tpII/2026-j2-pressure-sensitive-stylus/docs/img/Captura de pantalla 2026-10-01 205044.png

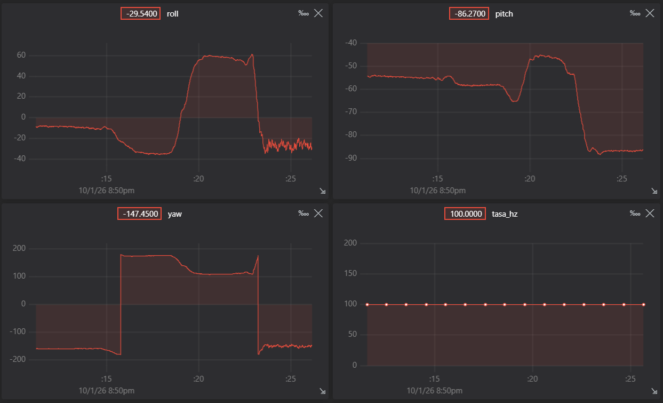
docs/img/Captura de pantalla 2026-10-01 205044.png
