tpII/2026-j2-pressure-sensitive-stylus/docs/img/Captura de pantalla 2026-10-10 220511.png

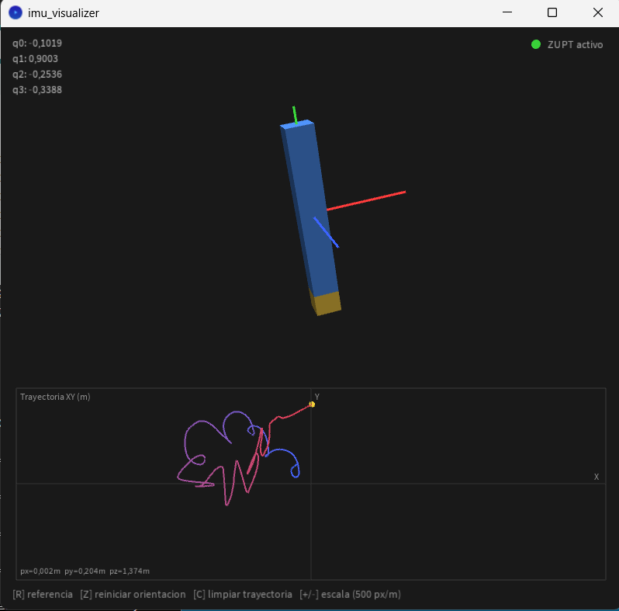
docs/img/Captura de pantalla 2026-10-10 220511.png
