tpII/2026-j2-pressure-sensitive-stylus/firmware/ensayos/resultados/2026-10-01_t3_resumen.md

# Test 3 - Calibracion estatica y deriva del giroscopo (2026-10-01)

Hardware: ESP32 DevKit (ESP-WROOM-32) + GY-521 MPU6050 original (WHO_AM_I = 0x68), en protoboard, alimentado por USB.
Configuracion: acelerometro +-4 g, giroscopo +-500 dps, DLPF 44 Hz, muestreo 100 Hz.
Archivos: `2026-10-01_t3_calibracion_salida.txt` (salida completa), `2026-10-01_t3_deriva.csv` (tabla de deriva).

## Offsets y ruido (1000 muestras, sensor quieto)

| Eje | Media | Desvio (ruido) |
|---|---|---|
| ax | +1.0280 g | 0.0017 g |
| ay | -0.0198 g | 0.0024 g |
| az | -0.0855 g | 0.0026 g |
| gx | -0.4318 deg/s | 0.0459 deg/s |
| gy | -0.1643 deg/s | 0.0951 deg/s |
| gz | +0.5116 deg/s | 0.0488 deg/s |

- |g| medido = 1.0317 g (error de escala/offset del acelerometro ~3 %).
- La gravedad cayo sobre el eje X (ax ~ 1 g): el sensor estaba apoyado de costado, no con el chip hacia arriba. No afecta el bias del giroscopo ni la deriva; para el offset del acelerometro conviene repetir con el sensor plano.
- Ruido del giroscopo: 0.05-0.10 deg/s; ruido del acelerometro: ~2-3 mg.

## Deriva por integracion del giroscopo (60 s)

| | X | Y | Z |
|---|---|---|---|
| Sin correccion de bias | -25.4 deg | -9.5 deg | +30.4 deg |
| Con correccion de bias | +0.55 deg | +0.34 deg | -0.27 deg |

- Sin correccion, la deriva es lineal y coincide con bias x tiempo (ej. -0.4318 deg/s x 60 s = -25.9 deg): el error dominante es el bias constante.
- Restando el bias medido, la deriva baja a < 0.6 deg/min (reduccion ~50x). El residuo crece lentamente: deriva del bias (temperatura) y ruido integrado (random walk).
- Conclusion: la integracion pura del giroscopo no alcanza ni con calibracion para uso prolongado; justifica fusionar con el acelerometro (filtro de Madgwick) para roll/pitch. El yaw no tiene referencia absoluta y conserva esta deriva residual.
