tpII/2026-j2-pressure-sensitive-stylus/docs/resultados/ensayos_iniciales_t1-t4/2026-10-01_204615_t4_madgwick.csv

t_s | variable | valor
0.0035 | roll | 103.09
0.0045 | pitch | -83.91
0.0045 | yaw | 41.27
0.0130 | roll | 102.4
0.0130 | pitch | -83.84
0.0140 | yaw | 41.96
0.0227 | roll | 101.64
0.0237 | pitch | -83.81
0.0237 | yaw | 42.72
0.0329 | roll | 100.98
0.0339 | pitch | -83.74
0.0339 | yaw | 43.38
0.0429 | roll | 100.75
0.0429 | pitch | -83.84
0.0439 | yaw | 43.6
0.0519 | roll | 101.51
0.0529 | pitch | -83.88
0.0529 | yaw | 42.85
0.0620 | roll | 102.2
0.0630 | pitch | -83.94
0.0630 | yaw | 42.16
0.0725 | roll | 101.5
0.0725 | pitch | -83.98
0.0735 | yaw | 42.85
0.0820 | roll | 102.02
0.0830 | pitch | -83.91
0.0840 | yaw | 42.34
0.0920 | roll | 102.78
0.0930 | pitch | -83.96
0.0930 | yaw | 41.59
0.1020 | roll | 102.06
0.1030 | pitch | -83.9
0.1030 | yaw | 42.31
0.1120 | roll | 101.29
0.1130 | pitch | -83.9
0.1130 | yaw | 43.07
0.1225 | roll | 101.97
0.1225 | pitch | -83.97
0.1235 | yaw | 42.39
0.1325 | roll | 101.52
0.1325 | pitch | -83.87
0.1335 | yaw | 42.83
0.1420 | roll | 102.15
0.1430 | pitch | -83.82
0.1430 | yaw | 42.21
0.1517 | roll | 101.43
0.1527 | pitch | -83.84
0.1527 | yaw | 42.93
0.1622 | roll | 100.71
0.1622 | pitch | -83.87
0.1632 | yaw | 43.65
0.1712 | roll | 101.44
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
