tpII/2026-j2-pressure-sensitive-stylus/docs/resultados/ensayos_iniciales_t1-t4/2026-10-01_212619_t4_beta_0.03.csv

t_s | variable | valor
0.0036 | roll | 154.76
0.0036 | pitch | -80.22
0.0036 | yaw | -77.89
0.0119 | roll | 154.76
0.0119 | pitch | -80.25
0.0119 | yaw | -77.89
0.0231 | roll | 154.63
0.0231 | pitch | -80.23
0.0231 | yaw | -77.77
0.0322 | roll | 154.72
0.0322 | pitch | -80.2
0.0322 | yaw | -77.87
0.0422 | roll | 154.91
0.0432 | pitch | -80.2
0.0432 | yaw | -78.07
0.0521 | roll | 154.72
0.0521 | pitch | -80.18
0.0531 | yaw | -77.88
0.0623 | roll | 154.52
0.0633 | pitch | -80.17
0.0633 | yaw | -77.69
0.0716 | roll | 154.67
0.0716 | pitch | -80.18
0.0716 | yaw | -77.85
0.0818 | roll | 154.71
0.0828 | pitch | -80.19
0.0828 | yaw | -77.9
0.0920 | roll | 154.82
0.0925 | pitch | -80.19
0.0925 | yaw | -78.02
0.1019 | roll | 154.94
0.1019 | pitch | -80.2
0.1019 | yaw | -78.15
0.1120 | roll | 155.05
0.1120 | pitch | -80.22
0.1120 | yaw | -78.26
0.1220 | roll | 155.14
0.1230 | pitch | -80.24
0.1230 | yaw | -78.34
0.1326 | roll | 154.91
0.1326 | pitch | -80.22
0.1326 | yaw | -78.12
0.1423 | roll | 154.84
0.1433 | pitch | -80.18
0.1433 | yaw | -78.05
0.1523 | roll | 154.65
0.1523 | pitch | -80.17
0.1533 | yaw | -77.87
0.1623 | roll | 154.5
0.1623 | pitch | -80.17
0.1623 | yaw | -77.72
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
