tpII/2026-j2-pressure-sensitive-stylus/docs/resultados/ensayos_iniciales_t1-t4/2026-10-01_212704_t4_beta_0.1.csv

t_s | variable | valor
0.0040 | roll | -172.87
0.0040 | pitch | -79.7
0.0040 | yaw | -0.24
0.0140 | roll | -173.45
0.0140 | pitch | -79.73
0.0150 | yaw | 0.34
0.0241 | roll | -172.89
0.0241 | pitch | -79.76
0.0241 | yaw | -0.21
0.0341 | roll | -173.06
0.0341 | pitch | -79.84
0.0341 | yaw | -0.03
0.0445 | roll | -172.96
0.0445 | pitch | -79.75
0.0445 | yaw | -0.12
0.0537 | roll | -172.95
0.0537 | pitch | -79.67
0.0549 | yaw | -0.12
0.0642 | roll | -173.01
0.0642 | pitch | -79.75
0.0642 | yaw | -0.05
0.0741 | roll | -173.55
0.0741 | pitch | -79.8
0.0741 | yaw | 0.49
0.0841 | roll | -173.53
0.0841 | pitch | -79.88
0.0851 | yaw | 0.48
0.0946 | roll | -173.22
0.0946 | pitch | -79.81
0.0955 | yaw | 0.18
0.1045 | roll | -173.15
0.1045 | pitch | -79.9
0.1045 | yaw | 0.11
0.1137 | roll | -172.5
0.1151 | pitch | -79.89
0.1151 | yaw | -0.52
0.1233 | roll | -173.13
0.1233 | pitch | -79.88
0.1243 | yaw | 0.11
0.1337 | roll | -173.68
0.1350 | pitch | -79.84
0.1350 | yaw | 0.66
0.1445 | roll | -174.22
0.1445 | pitch | -79.8
0.1450 | yaw | 1.21
0.1536 | roll | -173.63
0.1536 | pitch | -79.75
0.1536 | yaw | 0.63
0.1643 | roll | -172.99
0.1643 | pitch | -79.75
0.1643 | yaw | 0.0
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
