tpII/2026-j2-pressure-sensitive-stylus/docs/resultados/ensayos_iniciales_t1-t4/2026-10-01_212749_t4_beta_0.3.csv

t_s | variable | valor
1.4388 | roll | -135.72
1.4388 | pitch | -88.17
1.4388 | yaw | 0.72
1.4445 | roll | -131.47
1.4445 | pitch | -88.36
1.4445 | yaw | -3.54
1.4562 | roll | -137.03
1.4562 | pitch | -88.17
1.4562 | yaw | 2.01
1.4603 | roll | -140.46
1.4603 | pitch | -87.94
1.4603 | yaw | 5.43
1.4772 | roll | -136.93
1.4772 | pitch | -88.16
1.4772 | yaw | 1.9
1.4772 | roll | -145.7
1.4772 | pitch | -88.13
1.4772 | yaw | 10.67
1.4918 | roll | -137.8
1.4918 | pitch | -88.2
1.4918 | yaw | 2.77
1.5076 | roll | -137.97
1.5076 | pitch | -87.92
1.5076 | yaw | 2.95
1.5178 | roll | -135.86
1.5178 | pitch | -88.17
1.5178 | yaw | 0.85
1.5237 | roll | -138.87
1.5237 | pitch | -87.94
1.5237 | yaw | 3.86
1.5237 | roll | -140.77
1.5237 | pitch | -88.22
1.5237 | yaw | 5.76
1.5395 | roll | -142.48
1.5395 | pitch | -87.97
1.5395 | yaw | 7.47
1.5553 | roll | -134.2
1.5553 | pitch | -87.87
1.5553 | yaw | -0.81
1.5659 | roll | -135.4
1.5659 | pitch | -88.16
1.5659 | yaw | 0.38
1.5773 | roll | -138.09
1.5773 | pitch | -87.92
1.5773 | yaw | 3.06
1.5869 | roll | -134.34
1.5869 | pitch | -88.11
1.5869 | yaw | -0.7
1.5967 | roll | -141.29
1.5967 | pitch | -88.0
1.5967 | yaw | 6.24
1.6051 | roll | -133.74
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
