tpII/2026-j2-pressure-sensitive-stylus/docs/resultados/ensayos_iniciales_t1-t4/2026-10-01_212834_t4_beta_0.5.csv

t_s | variable | valor
1.3870 | roll | -161.55
1.3870 | pitch | -86.54
1.3870 | yaw | -0.79
1.3951 | roll | -163.94
1.3951 | pitch | -86.17
1.3951 | yaw | 1.58
1.4051 | roll | -160.32
1.4051 | pitch | -86.52
1.4051 | yaw | -2.05
1.4136 | roll | -155.93
1.4136 | pitch | -86.86
1.4136 | yaw | -6.43
1.4245 | roll | -157.68
1.4245 | pitch | -86.47
1.4245 | yaw | -4.69
1.4245 | roll | -157.85
1.4245 | pitch | -86.9
1.4245 | yaw | -4.53
1.4406 | roll | -160.46
1.4406 | pitch | -86.52
1.4406 | yaw | -1.93
1.4564 | roll | -168.58
1.4564 | pitch | -86.81
1.4564 | yaw | 6.15
1.4665 | roll | -158.82
1.4665 | pitch | -86.66
1.4670 | yaw | -3.61
1.4764 | roll | -157.34
1.4769 | pitch | -87.07
1.4774 | yaw | -5.12
1.4807 | roll | -158.28
1.4807 | pitch | -86.67
1.4877 | yaw | -4.22
1.4877 | roll | -162.99
1.4877 | pitch | -86.37
1.4877 | yaw | 0.47
1.5047 | roll | -157.89
1.5047 | pitch | -86.68
1.5047 | yaw | -4.63
1.5047 | roll | -167.04
1.5047 | pitch | -86.94
1.5047 | yaw | 4.5
1.5195 | roll | -157.05
1.5195 | pitch | -86.77
1.5195 | yaw | -5.48
1.5356 | roll | -153.96
1.5356 | pitch | -87.14
1.5356 | yaw | -8.56
1.5455 | roll | -158.22
1.5455 | pitch | -86.8
1.5475 | yaw | -4.31
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
