tpII/2026-j2-pressure-sensitive-stylus/docs/resultados/ensayos_iniciales_t1-t4/2026-10-01_212619_t4_beta_0.03_resumen.md

# Temporizacion - t4_beta_0.03 (2026-10-01 21:27)

Duracion: 40 s - ventanas de 1 s (se descarta la primera).

| Metrica | Minimo | Promedio | Maximo | Ventanas |
|---|---|---|---|---|
| tasa_hz | 100.0 | 100.0 | 100.0 | 39 |
| filtro_max_us | 25.0 | 25.0 | 25.0 | 39 |
| ciclo_max_us | 902.0 | 907.3 | 910.0 | 39 |
