tpII/2026-j2-pressure-sensitive-stylus/docs/resultados/ensayos_iniciales_t1-t4/2026-10-01_212704_t4_beta_0.1_resumen.md

# Temporizacion - t4_beta_0.1 (2026-10-01 21:27)

Duracion: 40 s - ventanas de 1 s (se descarta la primera).

| Metrica | Minimo | Promedio | Maximo | Ventanas |
|---|---|---|---|---|
| tasa_hz | 100.0 | 100.0 | 100.0 | 38 |
| filtro_max_us | 25.0 | 25.0 | 25.0 | 38 |
| ciclo_max_us | 894.0 | 906.4 | 917.0 | 38 |
