tpII/2026-j2-pressure-sensitive-stylus/docs/resultados/ensayos_iniciales_t1-t4/2026-10-01_212749_t4_beta_0.3_resumen.md

# Temporizacion - t4_beta_0.3 (2026-10-01 21:28)

Duracion: 40 s - ventanas de 1 s (se descarta la primera).

| Metrica | Minimo | Promedio | Maximo | Ventanas |
|---|---|---|---|---|
| tasa_hz | 100.0 | 100.0 | 100.0 | 37 |
| filtro_max_us | 25.0 | 25.0 | 25.0 | 37 |
| ciclo_max_us | 900.0 | 904.6 | 910.0 | 37 |
