tpII/2026-j2-pressure-sensitive-stylus/docs/resultados/ensayos_iniciales_t1-t4/2026-10-01_212834_t4_beta_0.5_resumen.md

# Temporizacion - t4_beta_0.5 (2026-10-01 21:29)

Duracion: 40 s - ventanas de 1 s (se descarta la primera).

| Metrica | Minimo | Promedio | Maximo | Ventanas |
|---|---|---|---|---|
| tasa_hz | 100.0 | 100.0 | 100.0 | 37 |
| filtro_max_us | 25.0 | 25.0 | 25.0 | 37 |
| ciclo_max_us | 895.0 | 902.7 | 908.0 | 37 |
