tpII/2026-j2-pressure-sensitive-stylus/firmware/ensayo_desplazamiento_integracion_pura/resultados/2026-10-23_191540_linea_recta_trazos.csv

trazo | largo_real_cm | largo_A_cm | largo_B_cm | vertical_A_cm | vertical_B_cm | angulo_AB_deg | inclinacion_max_deg | saturo
1 | 20.0 | 54.904778 | 9.29091 | 0.77 | 3.16 | 100.01089 | 0.6 | 0
2 | 20.0 | 3.6785333 | 8.817851 | -0.59999996 | -0.3800001 | 155.68211 | 0.6 | 0
3 | 20.0 | 9.792947 | 2.980956 | -0.47000003 | -0.52 | 162.69333 | 0.6 | 0
4 | 20.0 | 1.75 | 2.06 | 0.0 | 0.01999998 | 0.0 | 0.6 | 0
5 | 20.0 | 4.420886 | 6.8721533 | 0.01000002 | 0.07999992 | 177.67155 | 0.6 | 0
6 | 20.0 | 1.7355675 | 0.5047776 | 0.109999985 | 0.10000014 | 92.839554 | 0.7 | 0
7 | 20.0 | 8.181343 | 8.376353 | 0.10000001 | 0.00999999 | 0.37062266 | 0.8 | 0
8 | 20.0 | 2.912902 | 0.13038385 | 0.0 | 0.0 | 0.0 | 1.0 | 0
9 | 20.0 | 0.53935033 | 0.15297063 | 0.0 | 0.0 | 0.0 | 0.9 | 0
10 | 20.0 | 3.0506399 | 12.587432 | 0.0 | 0.76 | 23.321396 | 1.1 | 0
11 | 20.0 | 10.795062 | 18.680386 | -0.65000004 | -0.69000006 | 3.3948257 | 1.1 | 0
12 | 20.0 | 1.755705 | 1.9051772 | 0.0 | 0.00999999 | 9.649827 | 1.0 | 0
13 | 20.0 | 21.480598 | 16.185747 | -5.77 | -3.59 | 133.17926 | 1.5 | 0
14 | 20.0 | 0.89286137 | 0.32249013 | 0.07000017 | 0.06999993 | 0.0 | 1.4 | 0
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
