tpII/2026-j2-pressure-sensitive-stylus/docs/resultados/ensayos_iniciales_t1-t4/2026-10-01_211510_t2_lectura_cruda.csv

t_s | variable | valor
0.0108 | ax | 0.991
0.0108 | ay | 0.219
0.0108 | az | 0.084
0.0108 | gx | -0.29
0.0118 | gy | -0.26
0.0118 | gz | 0.44
0.0188 | ax | 0.992
0.0188 | ay | 0.221
0.0203 | az | 0.081
0.0203 | gx | -0.24
0.0203 | gy | -0.23
0.0203 | gz | 0.49
0.0298 | ax | 0.992
0.0298 | ay | 0.22
0.0298 | az | 0.082
0.0308 | gx | -0.24
0.0308 | gy | -0.26
0.0308 | gz | 0.49
0.0393 | ax | 0.993
0.0393 | ay | 0.218
0.0403 | az | 0.084
0.0403 | gx | -0.35
0.0403 | gy | -0.26
0.0403 | gz | 0.55
0.0496 | ax | 0.994
0.0496 | ay | 0.22
0.0506 | az | 0.084
0.0506 | gx | -0.37
0.0506 | gy | -0.26
0.0516 | gz | 0.49
0.0587 | ax | 0.993
0.0597 | ay | 0.218
0.0597 | az | 0.083
0.0597 | gx | -0.38
0.0597 | gy | -0.23
0.0597 | gz | 0.43
0.0692 | ax | 0.995
0.0702 | ay | 0.217
0.0702 | az | 0.084
0.0702 | gx | -0.31
0.0712 | gy | -0.23
0.0712 | gz | 0.43
0.0792 | ax | 0.997
0.0802 | ay | 0.218
0.0802 | az | 0.084
0.0802 | gx | -0.29
0.0802 | gy | -0.2
0.0802 | gz | 0.41
0.0887 | ax | 0.993
0.0897 | ay | 0.219
0.0897 | az | 0.081
0.0897 | gx | -0.27
0.0897 | gy | -0.23
0.0897 | gz | 0.44
0.0993 | ax | 0.995
0.1003 | ay | 0.22
0.1003 | az | 0.079
0.1003 | gx | -0.26
0.1013 | gy | -0.34
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
