tpII/2026-j2-pressure-sensitive-stylus/firmware/ensayos/resultados/2026-10-01_t4_beta_comparacion.png

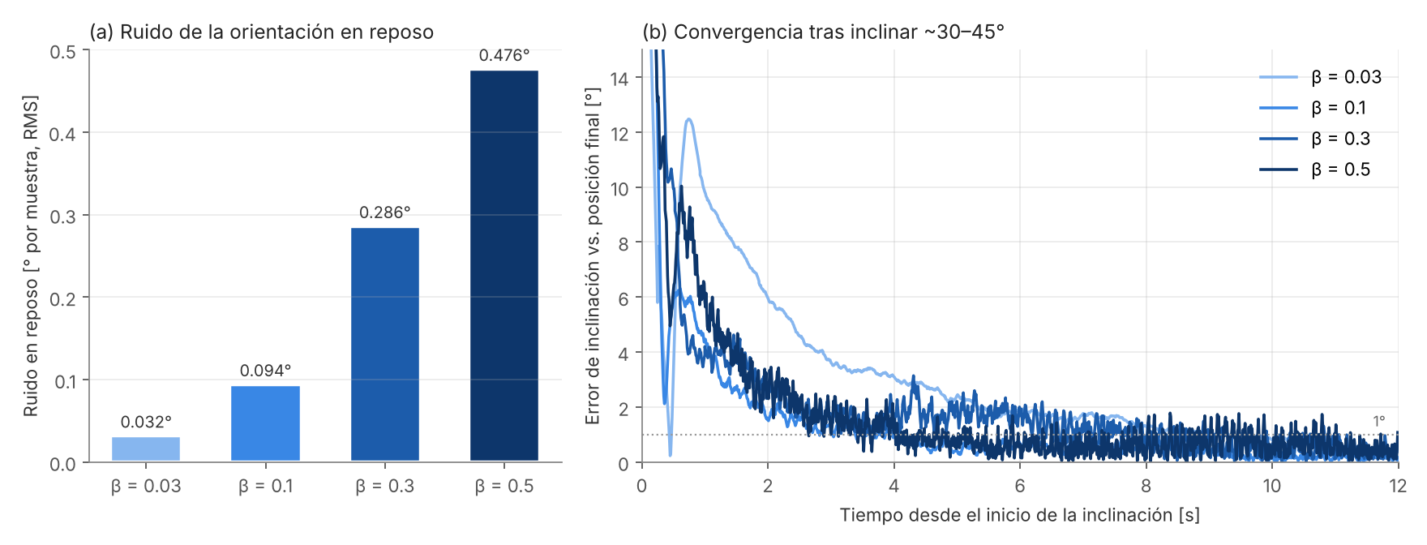
firmware/ensayos/resultados/2026-10-01_t4_beta_comparacion.png
