tpII/2026-j2-pressure-sensitive-stylus/BITACORA.md

## 30-09-2026

**Actividades realizadas**

* Recepción de los materiales provistos por la cátedra para el desarrollo del proyecto:
  * Placa de desarrollo ESP32
  * Módulo sensor MPU6050
  * Protoboard
  * Cable USB
* Verificación física de los componentes recibidos.

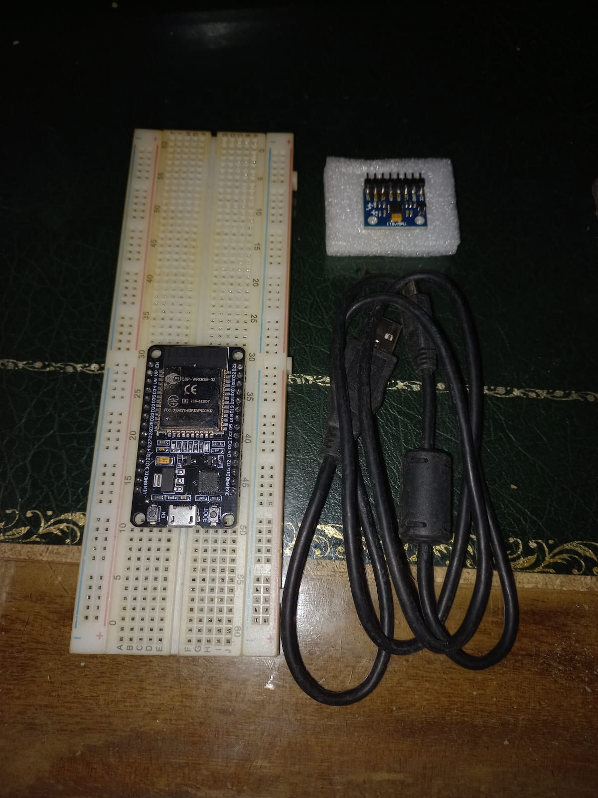
[picture p13: docs/img/materiales_recibidos.jpeg]


## 01-10-2026

**Actividades realizadas**

* Montaje del circuito en protoboard conectando el ESP32 con el MPU6050 vía I2C.
* Configuración del entorno de desarrollo en PlatformIO.
* Carga del firmware en el ESP32 y verificación del entorno.
* Desarrollo y ejecución de 4 tests unitarios/funcionales:
  * **Test I2C:** Verificación de comunicación exitosa y detección de ID correspondiente a MPU6050 original (dirección `0x68`).
  * **Test de lectura cruda:** Adquisición continua a 100 Hz estables con un jitter de ±1 µs.
  * **Test de calibración:** Medición de la deriva del giróscopo, registrando 30°/min sin corregir y reduciéndose a menos de 1°/min tras aplicar compensación de bias.
  * **Test de Madgwick:** Validación del filtro con un tiempo de cómputo de 25 µs por muestra, adoptando un factor β = 0.1.

## 03-10-2026

**Actividades realizadas**

* Se realizaron pruebas del firmware en un segundo ESP32 disponible, ya que el hardware principal no estaba accesible en ese momento.
* Fue necesario ajustar los pines de comunicación I2C ya que la asignación de pines difería entre las placas.
* Se detectó que el bus I2C fallaba de forma intermitente en la protoboard a alta velocidad. Se redujo la frecuencia de comunicación y la conexión se estabilizó.
* Se verificó mediante un programa de escaneo I2C que el MPU6050 es detectado correctamente en la dirección esperada.

## 05-10-2026

**Actividades realizadas**

* Se detectó un problema recurrente: luego de algunos movimientos bruscos, el firmware dejaba de responder y enviaba siempre los mismos valores por serial.
* Se identificó que la librería de comunicación I2C quedaba bloqueada ante errores sin ser detectados. Se agregó verificación de errores en cada lectura y una rutina de recuperación automática que reinicia el bus tras varios fallos consecutivos.
* Se agregó una espera al inicio para asegurarse de que el MPU6050 esté listo antes de continuar con la inicialización.

## 06-10-2026

**Actividades realizadas**

* Se desarrolló un visualizador 3D en Processing 4 para validar el movimiento del lápiz en pantalla contra el movimiento físico del MPU6050.
* El visualizador recibe la orientación por puerto serie y representa el lápiz como un objeto 3D rotando en tiempo real.
* Se implementó la funcionalidad de resetear la orientación de referencia en cualquier momento, útil para compensar la posición inicial del sensor.
* Al validar el movimiento con el visualizador se observó que el lápiz rotaba solo incluso cuando el sensor estaba quieto, lo que indicó un problema en la implementación del filtro.

## 08-10-2026

**Actividades realizadas**

* En reunión con el docente se identificó el error en la implementación del filtro de Madgwick: se usaba un intervalo de tiempo variable medido en cada iteración, cuando el filtro requiere un intervalo fijo definido por la frecuencia de muestreo. Usar un intervalo variable altera la ganancia del filtro y genera deriva artificial en los ángulos.
* Se releyó el paper de Madgwick, en particular el Apéndice A dedicado a la implementación optimizada en C, y se reescribió la función del filtro siguiendo esa referencia.
* Se ajustó el valor de β al recomendado en el paper para uso sin magnetómetro.

## 09-10-2026

**Actividades realizadas**
* Se agregó calibración de bias del giróscopo al inicio: se toman varias muestras con el sensor en reposo, se promedian y se restan en cada lectura antes de alimentar el filtro. Esto reduce la deriva significativamente.
* Con estos cambios el lápiz dejó de rotar solo durante los primeros minutos de uso. La deriva en yaw persiste a largo plazo, lo cual es esperable al no contar con magnetómetro.
* Se desarrolló un script de validación de ángulos con una secuencia guiada de posiciones conocidas (0°, ±45°, ±90°) en cada eje.
* Primera validación: los ejes estaban bien asignados, pero el filtro sobreestimaba entre 3° y 6°. Se identificó como causa un offset en el acelerómetro.
* Se incorporó la corrección de offset del acelerómetro en el firmware. Segunda validación: el error bajó a menos de 2° en el rango ±90°. El pitch en ±90° presenta singularidad (gimbal lock), lo cual es inherente a la representación de Euler.
* Se subió al repositorio el firmware y el visualizador.

**Pendientes**

* Iniciar el desarrollo de la lógica para la estimación del desplazamiento lineal.
* Evaluar la adopción de β = 0,1 (mejor resultado del ensayo de calibración del 01-10) frente al β sugerido en el paper de Madgwick, que es el que usa el firmware actual.

## 10-10-2026

**Actividades realizadas**

* Primer prototipo de estimación de desplazamiento: la aceleración se rota al marco del mundo con el cuaternión de Madgwick, se resta la gravedad (1 g en Z) y se integra dos veces (aceleración → velocidad → posición) a 100 Hz.
* Se implementó ZUPT (actualización de velocidad cero): cuando el sensor está en reposo, la velocidad se pone en cero para frenar la deriva de la integración.
* Configuración del MPU6050: filtro pasabajos digital (DLPF) en 44 Hz, giróscopo ±500 °/s y acelerómetro ±4 g, para reducir ruido y evitar saturación en movimientos rápidos.
* Temporización con período fijo de 10 ms sin acumulación de atraso, y puerto serie a 921600 baudios.
* La orientación inicial se calcula a partir del acelerómetro y se usa un β adaptativo: 0,033 en movimiento (valor sugerido por Madgwick) y 0,5 en reposo para corregir rápido la inclinación.
* El reposo se detecta con el módulo del acelerómetro (|a| ≈ 1 g) y el giro, promediados en ~0,1 s, de forma independiente de la orientación estimada. Antes, un error de orientación impedía detectar el reposo y la posición se desplazaba en línea recta.
* Mitigación de la deriva por doble integración: zona muerta de 0,02 g en la aceleración lineal y atenuación de la velocidad (factor 0,98 por muestra).
* Visualizador en Processing: se corrigió un cuelgue por acceso concurrente a la trayectoria desde el hilo serie, se agregó escala ajustable (+/-) y reinicio de orientación (tecla Z).
* Resultado: el lápiz digital sigue trazos cortos en el plano XY y se mantiene quieto en reposo. El eje Z presenta mayor deriva, al concentrar el residuo de la gravedad.

**Pendientes**

* Cuantificar el error de desplazamiento con trazos de longitud conocida.
* Evaluar la adopción de β = 0,1 (ensayo del 01-10) frente al β adaptativo actual.
* Medir el offset del eje X del acelerómetro o realizar una calibración en seis posiciones.
* Definir la orientación del sensor dentro del cuerpo del lápiz.

## 11-10-2026

**Actividades realizadas**

* Se desarrolló un visor de orientación en Processing 4 (`visor_orientacion_dibujo`) que funciona con el firmware de ensayo `t4_madgwick` sin modificarlo: al conectarse espera el fin de la calibración y envía el comando `l` para recibir el cuaternión en formato CSV. Si solo llega la salida para Teleplot, reconstruye el cuaternión desde roll, pitch y yaw.
* El visor tiene dos paneles: un modelo 3D del módulo GY-521 con sus ejes, rotado según la orientación relativa a una pose de referencia (tecla R), y un lienzo donde se dibuja inclinando el sensor.
* En la primera versión el dibujo no respondía de forma intuitiva: el cursor seguía el ángulo de giro alrededor de cada eje, pero girar alrededor de un eje inclina el sensor en la dirección perpendicular, y el giro sobre el propio eje vertical también movía el cursor. Se reescribió como joystick: al tomar la referencia se detecta qué eje del sensor queda vertical y el cursor sigue la inclinación de ese eje. Así el giro sobre la vertical (y la deriva del yaw) no afecta el trazo.
* Al probar el visualizador 3D (`visor_trayectoria_3d`) con el firmware `madgwick_filter`, la trayectoria se desplazaba al rotar el sensor sin trasladarlo y los trazos salían mucho más cortos que el movimiento real. Se identificaron dos causas:
  * La calibración inicial suponía el sensor apoyado plano y tomaba como offset todo lo distinto de (0, 0, 1 g). Con el sensor de costado en la protoboard se restaba 1 g del eje X y se sumaba 1 g al Z, y el residuo de gravedad mal restada se integraba como desplazamiento.
  * La atenuación de la velocidad de 0,98 por muestra la reducía a la mitad en ~0,35 s, acortando los trazos.
* Se corrigieron ambos puntos en el firmware (`madgwick_filter`): la calibración toma como gravedad el vector unitario en la dirección medida en reposo (válida en cualquier posición) y la atenuación pasó a 0,995 por muestra (~2 s de constante de tiempo), ya que el ZUPT anula la velocidad en cada reposo.
* Se grabó el video demostrativo con el visor: respuesta del modelo 3D a rotaciones en cada eje, estabilidad al soltar el sensor y dejarlo en reposo, y un trazo de prueba por inclinación. El desplazamiento no se incluyó por no estar validado.

**Pendientes**

* Cuantificar el error de desplazamiento con trazos de longitud conocida.
* Evaluar la adopción de β = 0,1 (ensayo del 01-10) frente al β adaptativo actual.
* Ensamblaje mecánico del lápiz, pendiente de la entrega del sensor KY-024.

## 22-10-2026

**Actividades realizadas**

* Se desarrolló un firmware de ensayo (`firmware/ensayo_beta_adaptativo_vs_fijo`) que ejecuta dos filtros de Madgwick en paralelo sobre las mismas muestras, de modo que ambos procesan exactamente el mismo movimiento en una única corrida de 40 s (reposo, inclinación sostenida de 30-45°, sacudida y reposo). Las métricas se calculan sobre la dirección de la gravedad estimada; durante la sacudida se usa como referencia la gravedad del sostén rotada únicamente con el giróscopo, y su validez se controla al final contra el acelerómetro en reposo (error < 2°).
* Se comparó el β adaptativo del firmware (0,033 en movimiento / 0,5 en reposo) contra β fijo 0,1 (dos corridas, inclinando en X y en Y). El valor 0,5 quintuplicaba el ruido de orientación en reposo (0,57° frente a 0,11° por muestra) sin converger más rápido que 0,1. Durante la sacudida, el β adaptativo tuvo un error alrededor de un 25 % menor.
* Se bajó el β en reposo a 0,1 (adaptativo 0,033 / 0,1). En dos corridas: ruido en reposo, convergencia y recuperación idénticos a β fijo 0,1, y error durante la sacudida aproximadamente la mitad (RMS 0,36° y 0,50° frente a 0,73° y 0,82°; máximo 0,79° y 1,01° frente a 2,00° y 1,73°).
* Se adoptó β = 0,033 en movimiento y 0,1 en reposo en `firmware/madgwick_filter`.
* Se adaptó `visor_orientacion_dibujo` para funcionar también con `madgwick_filter` (detecta el firmware por el formato de las líneas), de modo que ambos visores usan el β adoptado. Con `t4_madgwick` sigue funcionando igual que antes.

## 23-10-2026

**Actividades realizadas**

* Para determinar si el error del desplazamiento proviene de la doble integración, del acople con la orientación o de una saturación del sensor o del ESP32, se desarrolló el firmware `firmware/ensayo_desplazamiento_integracion_pura` y el visor `tools/visor_desplazamiento_integracion_pura`. Sobre las mismas muestras se calculan dos desplazamientos: A, con orientación (método actual: aceleración rotada al mundo con el cuaternión y resta de 1 g), y B, sin rotación (resta de una gravedad fija medida en reposo, válido solo si el sensor se desliza sin inclinarse). El visor muestra ambas trayectorias sobre el plano de la mesa, mide cada trazo contra el largo real e informa tasa, tiempo de ciclo, muestras perdidas y saturadas.
* Al validar el firmware con un sensor simulado se detectó que el detector de reposo de `madgwick_filter` (| |a| - 1 g |) no detecta un deslizamiento sin giro: una aceleración horizontal de 0,12 g eleva |a| a solo 1,007 g, el trazo se toma como reposo y el ZUPT anula la velocidad. En el ensayo se reemplazó por el módulo de la aceleración lineal (aceleración medida menos gravedad estimada).
* El indicador de giro inicialmente sumaba también el giro alrededor de la vertical, que no afecta a B; se corrigió para medir solo la inclinación.
* Resultados con el sensor real:
  * Saturación descartada: 100 Hz, ciclo de 1,8 ms sobre 10 ms disponibles, 0 muestras perdidas y 0 saturadas.
  * Trazos libres (15 trazos válidos de 20 cm): A midió en promedio el 37 % del largo real y B el 43 %, ambos de forma errática (B entre 3 % y 220 %). B no completa los círculos, la posición se corre sola al dejar el sensor quieto y, tras un rato de uso, se producen saltos de más de 40 cm.
  * Ida y vuelta en línea recta sobre una regla de 20 cm (22 trazos): A se desplazó 83 cm en una sola dirección sin reproducir el ida y vuelta. B siguió la dirección del movimiento con pasadas de 12-18 cm, pero cada pasada se corrió 2-5 cm hacia el mismo costado (unos 20 cm acumulados), mientras la inclinación estimada subía de 0,6° a 2,0°. El detector de reposo partió varios trazos en tramos de 1-2 cm, por lo que el registro por trazo de B (25 %) subestima el resultado.

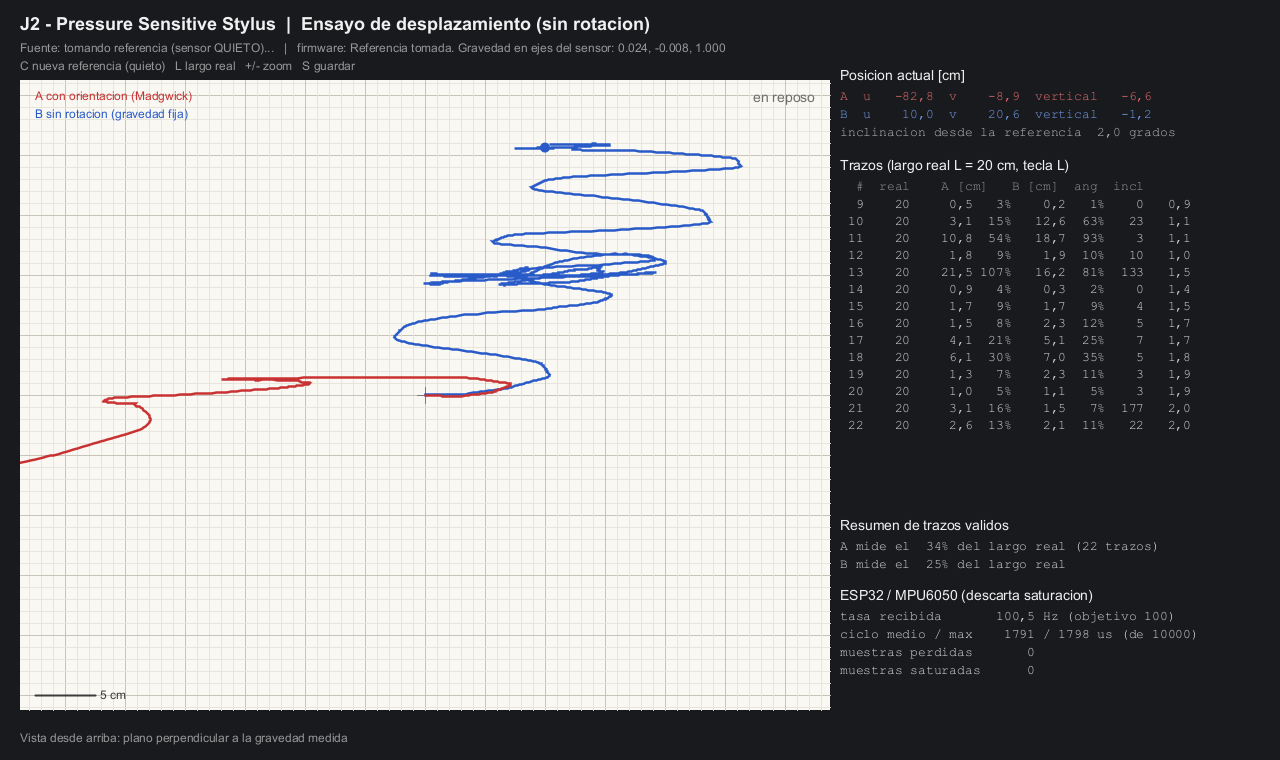
[picture p14: docs/img/desplazamiento_linea_recta_2026-10-23.png]


* Conclusión: el problema es la doble integración en sí, no la combinación con la orientación ni una saturación. Una inclinación de 1° deja 0,017 g de gravedad sin restar, que integrada dos veces produce un error de 2 cm en 0,5 s, 9 cm en 1 s y 34 cm en 2 s. Un error menor a 1 cm exigiría conocer la inclinación con centésimas de grado durante el movimiento. Ni otra IMU de 6 ejes ni dos IMUs resuelven el problema, porque comparten la misma gravedad y el error es sistemático, no ruido.

## 27-10-2026

**Actividades realizadas**

* Se definió la arquitectura de la transmisión por Wi-Fi. Por indicación docente, el sistema no puede depender de la red de la facultad el día de la entrega, por lo que el ESP32 levanta su propia red en modo punto de acceso (SoftAP) y la computadora se une a ella. No requiere router, credenciales ni conexión a internet.
* La SPA corre en la computadora, servida localmente, y el navegador es cliente WebSocket directo del ESP32. Se mantiene así el esquema de la Figura 1 del informe de avance, sin necesidad de alojar la interfaz en la placa.
* Se implementó el primer paso de la transmisión (`firmware/wifi_stream`): el ESP32 levanta el punto de acceso, abre un servidor WebSocket en el puerto 81 y emite un seno sintético a 50 Hz. No se leen sensores de forma deliberada, para validar el camino de red por separado del firmware de sensado.
* Cada mensaje incluye un número de secuencia y la marca de tiempo del envío, que permiten medir pérdida de paquetes y jitter de llegada. Ambos campos se conservarán en la versión final por ser datos del análisis de límites.
* Primera versión de la SPA (`webapp/index.html`): página única con gráfico en Canvas del dato recibido y panel de telemetría (tramas por segundo, jitter pico a pico, paquetes perdidos y total recibido), con reconexión automática.
* Se verificó el funcionamiento completo sobre la placa: la computadora se une a la red, la página conecta sola y el seno se grafica de forma continua.
* Se detectó que la placa Heltec WiFi LoRa 32 V3 utilizada para esta prueba monta un ESP32-S3 y no el ESP-WROOM-32 documentado en el informe. Sigue siendo de doble núcleo, por lo que el reparto de tareas previsto no cambia, pero los pines de la sección 3.2 no son válidos en esa placa: GPIO22 no existe en el S3 y GPIO34 no es canal de ADC. Además, el ADC2 queda inutilizable con el Wi-Fi activo, por lo que el sensor Hall deberá conectarse a un canal del ADC1.

## 28-10-2026

**Actividades realizadas**

* Se separó el sensado de la transmisión entre los dos núcleos del ESP32: el muestreo lo dispara un timer de hardware en el núcleo 1 y la transmisión corre en el núcleo 0, con una cola de 32 muestras entre ambos que se escribe sin espera. El muestreo pasó a 100 Hz y las tramas a 50 por segundo, con dos muestras cada una.
* Se agregaron al firmware contadores de muestras por segundo, período real mínimo y máximo, muestras atrasadas, descartes de cola y tiempo de la tarea de red. Se publican por el puerto serie y en cada trama, y la SPA los muestra aparte de las métricas de red.
* Se realizo un procedimiento de cinco pruebas, con una medición de referencia sin radio y una falla a proposito en la tarea de red.

**Pendientes**

* Agregar al esquema gráfico el cliente en el MCU y el formato de los mensajes (corrección del informe de avance).
* Corregir el detector de reposo de `madgwick_filter` (no detecta deslizamientos sin giro).
* Ensamblaje mecánico del lápiz, pendiente de la entrega del sensor KY-024.
* Reemplazar el dato sintético por el cuaternión, la posición estimada y el estado de contacto.

## 29-10-2026

**Actividades realizadas**

* Se modificó el ensayo de desplazamiento (`firmware/ensayo_desplazamiento_integracion_pura` y `tools/visor_desplazamiento_integracion_pura`) para medir la doble integración sin ninguna corrección: sin ZUPT, sin zona muerta, sin atenuación de la velocidad y sin detector de reposo. La integración solo se reinicia con la tecla `c`, que toma una referencia de 1 s con el sensor quieto (gravedad y bias del giróscopo).
* Se fijó β = 0,033 en el ensayo, porque el β adaptativo dependía del detector de reposo, que ya no se usa. B resta la gravedad medida en la referencia, en los ejes del propio sensor, de modo que el offset del acelerómetro se cancela.
* El firmware transmite además la lectura cruda (ax…gz) y la calibración (`#cfg`), y el visor graba cada corrida en un CSV con su etiqueta (reposo, trazo de L cm o libre), para reprocesar en la PC.
* Se agregó `tools/analizar_desplazamiento.py`, que ajusta la deriva en reposo a d = ½·b·g·t² y obtiene el error de aceleración constante equivalente b, además de comparar los trazos con su largo real.
* Resultados con el sensor quieto (cinco corridas válidas, de 14 a 524 s, con dos módulos MPU6050):
  * B (sin Madgwick): b entre 0,15 y 0,98 mg (media de 0,54 mg). Equivale a unos 3 mm de error en un trazo de 1 s y 11 mm en uno de 2 s.
  * A (con Madgwick): b entre 0,01 y 1,10 mg. En el plano, el filtro absorbe el residuo como si fuera inclinación, lo que en reposo favorece a A pero en movimiento absorbe parte de la aceleración real del trazo.
  * Se descartó la corrida `20261029_221855`: el sensor se movió (inclinación de hasta 8,3°).
* Conclusión: el piso del sensor en reposo es entre 17 y 110 veces menor que los 17 mg que deja 1° de inclinación mal estimada. El error en movimiento proviene de la orientación durante el trazo, no del ruido ni del offset del sensor, y no se resuelve cambiando de módulo.

**Pendientes**

* Repetir el reposo con los dos módulos en las mismas condiciones (5 min encendidos y 60 s quietos) para poder compararlos.
* Trazos de 5, 10 y 20 cm deslizando sin inclinar, los mismos agarrando el sensor como un lápiz, y círculos de 5 cm, para cuantificar el error en movimiento.
* Consultar con el docente el alcance del objetivo de desplazamiento.
* Corregir el detector de reposo de `madgwick_filter`.
* Ensamblaje mecánico del lápiz, pendiente de la entrega del sensor KY-024.

---

## 03-11-2026

**Actividades realizadas**

* Identificación del patillaje y conexionado del sensor Hall lineal SS49E (mirando la cara plana: Pin 1 VCC, Pin 2 GND, Pin 3 OUT). Se soldaron cables y se fijaron con cinta para evitar movimientos.
* Validación eléctrica con multímetro sobre Arduino Uno alimentando a 3.3 V:
  * Reposo (sin imán): salida estable en 1.64 V - 1.65 V (mitad de VCC).
  * Con imán cilíndrico: la tensión asciende hasta 2.3 V - 2.4 V y retorna a la línea base al alejarlo.
* Conexión de la salida al pin analógico A0 del microcontrolador.
* Configuración del proyecto en PlatformIO para Arduino Uno a 115200 baudios y desarrollo del firmware inicial (`main.cpp`): adquisición a 50 Hz (período de 20 ms con `millis()`) leyendo `analogRead(A0)` en crudo, sin filtros, enviando valor del ADC y voltaje por puerto serie.
* Puesta en marcha del dashboard web local (`node serve.js` vía Web Serial al COM5):
  * Se visualizó la señal cruda en tiempo real: reposo en ~1.60 V - 1.64 V (~330 cuentas de ADC) y picos de 2.35 V - 2.40 V (~490 cuentas) al acercar el imán.
  * Se confirmó la respuesta del sensor a 3.3 V y la estabilidad del conexionado previo a la integración en el microcontrolador final.

---

## 04-11-2026

**Actividades realizadas**

* Implementación de procesamiento digital sobre la lectura de A0 en el firmware:
  * **Filtro paso bajos IIR (EMA):** se aplicó suavizado exponencial de primer orden con $\alpha = 0.20$ para atenuar el ruido de alta frecuencia sin introducir retardo perceptible en la respuesta.
  * **Descarte de picos:** se incorporó un descarte de saltos bruscos (`SPIKE_THRESHOLD = 80`) para evitar lecturas espurias por falsos contactos o rebotes, validando la variación únicamente si se sostiene por dos ciclos consecutivos.
  * Se inicializaron las variables del filtro con la primera lectura del ADC para evitar arranques transitorios en 0 V.
* Validación con el visualizador web en tiempo real:
  * El ruido pico a pico en reposo bajó a unas 6 cuentas (~29 mV), eliminando el serrucho de la señal cruda y manteniendo una respuesta rápida al presionar y soltar el imán.

**Pendientes**

* Adaptar el firmware para validar la adquisición y el filtrado sobre una placa ESP.

---

## 05-11-2026

**Actividades realizadas**

* Se repitió el reposo con los dos módulos MPU6050 en las mismas condiciones. Los dos dan una deriva de 0,1 a 0,3 mg (1 a 2 mm en un trazo de 2 s). Se eligió el módulo usado hasta ahora, porque el otro tiene un offset del giróscopo anómalo (−24 °/s en x).
* Se agregó `tools/calibrar_imu.py`, que calcula el offset y la escala del acelerómetro (6 caras quietas) y la escala del giróscopo (giros de 360°) y los guarda en `tools/calibracion_imu.json`. La calibración corrige un error de |g| de hasta 47 mg según la cara (≈2,7° de inclinación falsa); se usaron 6 posiciones, así que el ajuste no tiene posiciones de sobra para verificarlo. El error de escala del giróscopo es menor al 0,5 %.
* Se agregó `tools/reprocesar_desplazamiento.py`, que recalcula el desplazamiento en la PC a partir de la lectura cruda y compara variantes sobre las mismas muestras.
* Trazos deslizando el sensor sin inclinarlo (5, 10 y 20 cm, 26 corridas):
  * Con Madgwick (β = 0,033) durante el trazo, el error es de ~50 %: el filtro toma la aceleración del trazo como inclinación.
  * Con la orientación solo del giróscopo durante el trazo (β = 0) y la corrección de velocidad al frenar, el error baja a 2–10 % (los largos se marcaron a ojo).
* Círculos de 5 cm (3 vueltas seguidas, 7 a 10 s): el diámetro dio 8–11 cm y no cerró por 1–4 cm. En movimientos continuos largos la deriva sigue siendo grande.
* Se integró el sensor Hall SS49E al ESP32 en un firmware nuevo, `firmware/ensayo_desplazamiento_hall` (salida al GPIO 4, filtro EMA y descarte de picos, contacto con histéresis). Base de 1708 mV y ruido de 20–30 mV; detecta los dos polos del imán.
* Pruebas con el Hall: los trazos cortados por contacto miden igual que cortados por reposo (5,1–6,5 cm en trazos de 5 cm). En trazos encadenados, reiniciar la integración en cada apoyo da ~0 cm, porque el lápiz se mueve en ese instante; integrando la pasada completa de reposo a reposo, el recorrido dio 9,7 cm contra 9,5 cm reales.
* Se agregó `tools/visor_dibujo_hall`, una muestra de la versión final: dibuja moviendo el sensor, deja tinta solo con contacto del Hall y el grosor depende de la presión. El trazo se vuelve definitivo al frenar, y cada reposo es el nuevo punto de partida.
* Conclusión: con IMU y Hall se puede dibujar en trazos cortos con pausas. Las pasadas continuas de más de unos segundos siguen derivando.

**Pendientes** 

* Prueba agarrando el sensor como un lápiz real (inclinado), con el mecanismo de la punta.
* Repetir los trazos encadenados con el contacto dado por la punta del lápiz, no con un imán a mano.
* Pasar el Hall a un pin del ADC1 cuando se integre con `wifi_stream`.
* Presentar el visor de dibujo al docente y acordar el alcance del objetivo de desplazamiento.

---

## 09-11-2026

**Actividades realizadas**

* Se agregaron herramientas para las pruebas que faltan:
  * `tools/visor_joystick_hall`: alternativa en la que el cursor se mueve con la inclinación del lápiz (no con la doble integración), con embrague por el Hall y grosor por presión.
  * `tools/calibrar_presion_hall.py`: curva de presión del Hall con una balanza (fuerza mínima de contacto, resolución e histéresis).
  * `firmware/ensayo_latencia_wifi` y `tools/medir_latencia_wifi`: medición de la latencia del enlace Wi-Fi (ida y vuelta) con las tramas circulando.

---

## 10-11-2026

**Actividades realizadas**

* Se agregó `firmware/ensayo_dmp_vs_madgwick`, que lee en cada muestra el cuaternión del DMP del MPU6050 y la lectura cruda, y `tools/comparar_dmp_madgwick.py`, que graba las corridas y calcula sobre la misma lectura cuatro variantes del Madgwick (β fijo 0,1 y 0,033, adaptativo y β = 0 en movimiento).

---

## 11-11-2026

**Actividades realizadas**

* Ensayo DMP contra Madgwick (reposo, 6 caras, deslizar 10 cm sin inclinar y giros volviendo al mismo tope):
  * En reposo el DMP tiene menos ruido de inclinación (0,005° contra 0,03–0,05°) y deriva del *yaw* de 0,25 °/min; el Madgwick que recalibra el bias en reposo queda en ~0.
  * Quieto, los dos coinciden con el acelerómetro (0,01–0,02°): la exactitud estática la pone la calibración del acelerómetro, no el filtro.
  * Deslizando 10 cm, el error del largo fue de 27 % con el DMP, 4,9 % con β = 0 en movimiento y 40–68 % con β fijo.
  * Volviendo al mismo tope, el DMP no vuelve por 0,57° en *yaw* (0,03° el Madgwick) y tiene ~10 ms de retardo.
  * Se descartaron dos corridas de reposo (escala del acelerómetro mal leída en la primera versión del firmware) y una de deslizar (vacía).
  * Conclusión: se sigue con el Madgwick. El DMP no permite cambiar la ganancia durante el trazo, no acepta la calibración propia y fija las escalas en ±2 g y ±2000 °/s.
* Se probó la versión joystick sin registrar resultados: funciona aceptablemente.
* Se armó el lápiz sin el Hall: IMU a 12,5 cm de la punta, con el eje Y del sensor a lo largo del lápiz, apuntando hacia arriba.
* Trazos rectos de 5, 10 y 20 cm y círculos de 5 cm con el lápiz en la mano:
  * Con el lápiz en la mano el giróscopo varía 1–2 °/s por el pulso (apoyado en la mesa, 0,05 °/s), así que las pausas en la mano no sirven para estimar el bias.
  * El bias de este módulo, medido con el lápiz acostado en la mesa, es −1,17 / −0,28 / −1,39 °/s y es estable.
  * Con el bias de cada pausa en la mano, la mediana del error fue de 281 %; con el bias fijo medido en la mesa, de 70 % (61 % con la corrección de la posición de la punta).
  * Levantar o acostar el lápiz dentro de una pasada gira ~275° y deja la orientación corrida 2°, lo que arruina el trazo.
  * Conclusión: el método de trazos cortos validado sobre la mesa (2–10 %) todavía no se sostiene con el lápiz en la mano.
* Se agregó `tools/visor_lapiz_hall` (`MotorLapiz.java`), una versión del visor de dibujo para el lápiz armado: bias medido con el lápiz acostado en la mesa, pausas detectadas con el lápiz en la mano, posición de la punta y descarte de las pasadas con giros grandes. Todavía no se probó con el lápiz.

**Pendientes**

* Probar `visor_lapiz_hall` con el lápiz armado y el Hall montado.
* Montar el Hall y el imán en la punta del lápiz; curva de presión con `calibrar_presion_hall.py`.
* Definir con el docente el alcance del objetivo de desplazamiento (IMU, versión joystick o sensor óptico en la punta).
* Medición de latencia Wi-Fi (Juan Pablo).
* Pasar el Hall a un pin del ADC1 cuando se integre con `wifi_stream`.
