tpII/2026-j2-pressure-sensitive-stylus/(commit log)

2026-10-01 Add project activity log for September 30, 2026
    Document activities related to project materials received and verified.
2026-10-02 Update BITACORA.md with activities from 01-10-2026
    Document activities and tests performed on 01-10-2026, including circuit assembly and unit tests for the ESP32 and MPU6050.
2026-10-02 Change image format in BITACORA.md
    Updated image syntax for received materials.
2026-10-10 Estructura de firmware, herramientas de visualización y bitácora actualizada
2026-10-28 Ensayos de beta y desplazamiento, bitácora 22/10 al 27/10
    - madgwick_filter: beta en reposo 0.5 -> 0.1 (beta adaptativo 0.033 / 0.1)
    - ensayo_beta: compara beta adaptativo vs fijo con dos filtros en paralelo
    - ensayo_desplazamiento + visor_desplazamiento: desplazamiento con
    orientacion vs sin rotacion, tiempo de ciclo y saturacion
    - visor_lapiz: funciona tambien con madgwick_filter
    - Resultado del ensayo en linea recta (CSV y captura)
    - Bitacora actualizada (22-10, 23-10, 27-10)
2026-10-28 Transmision WiFi paso 1: SoftAP + WebSocket y SPA de telemetria
    - firmware/wifi_stream: el ESP32 levanta la red J2-Stylus (SoftAP), abre un
    servidor WebSocket en el puerto 81 y emite un seno sintetico a 50 Hz con
    seq y marca de tiempo para medir perdidas y jitter
    - webapp/index.html: SPA que se conecta al ESP32, grafica el dato y muestra
    tramas/s, jitter pico a pico, paquetes perdidos y total recibido
    - README con preparacion del IDE, prueba, formato del mensaje y notas de
    pines para la Heltec WiFi LoRa 32 V3 (ESP32-S3)
2026-10-31 Transmision WiFi paso 2: ajustes de firmware y SPA, documentacion Tarea 2
2026-11-04 primeras pruebas del hall SS49E sobre un arduino UNO, datos en crudo y visualizador
2026-11-04 Aplicado filtro IIR (EMA) y descarte de picos para reducir ruido
2026-11-05 Reorganizacion del repo: se eliminan ensayos t1-t4, se renombran ensayos y visores
    - Se elimina el proyecto PlatformIO firmware/ensayos (t1-t4, librerias y scripts).
    Sus resultados pasan a docs/resultados/ensayos_iniciales_t1-t4 (sin las corridas vacias o cortadas).
    - ensayo_beta -> ensayo_beta_adaptativo_vs_fijo
    - ensayo_desplazamiento -> ensayo_desplazamiento_integracion_pura (version del 29/10)
    - visor_lapiz -> visor_orientacion_dibujo
    - imu_visualizer -> visor_trayectoria_3d
    - visor_desplazamiento -> visor_desplazamiento_integracion_pura (version del 29/10, con corridas)
    - Se agrega tools/analizar_desplazamiento.py
    - Bitacora: nombres actualizados, entrada del 29/10 y arreglo de calibr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
2026-11-06 Ensayos de desplazamiento del 05/11, Hall en el ESP32 y visor de dibujo
    - Calibracion de la IMU (tools/calibrar_imu.py y calibracion_imu.json) y
    reprocesamiento de variantes del desplazamiento (tools/reprocesar_desplazamiento.py).
    - Firmware ensayo_desplazamiento_hall: el ensayo de integracion pura con el
    Hall SS49E leido en el ESP32 (GPIO 4).
    - Visor de desplazamiento con etiquetas nuevas y soporte del Hall; analizar_desplazamiento
    acepta las corridas con Hall.
    - Visor de dibujo con IMU + Hall (tools/visor_dibujo_hall).
    - Corridas del 05/11; se eliminan las corridas de reposo del 29/10.
    - Bitacora del 05/11, README actualizado y .gitignore.
2026-11-09 Correcciones de Bitacora
